Zengys118/FishFeeder-v2/sw/装配体2.STEP

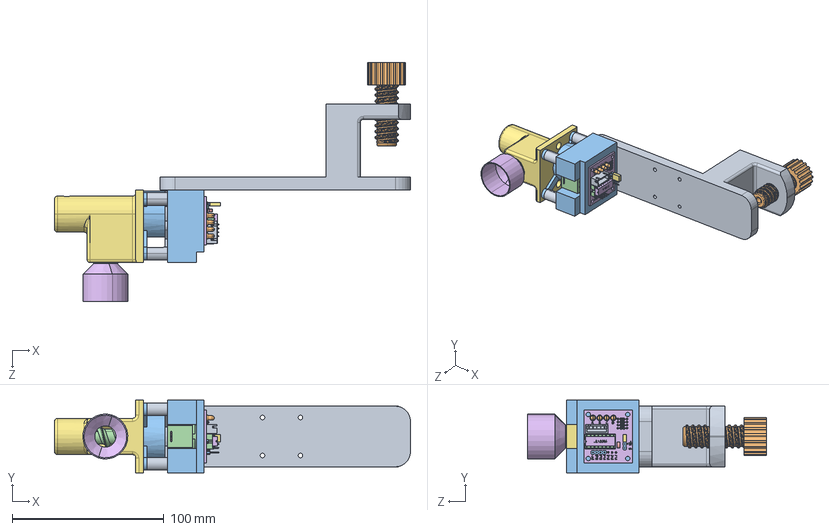
[picture p1: CAD file, 2026-11-01]
sw/装配体2.STEP
234.5 x 48.0 x 157.5 mm
夹具
夹具螺杆
电机料仓座
28BYJ-48_5VDC
board.step
5.2Kohm.step x 4
LED_Small.step x 4
DIP_16_Socket.step
ULN2003_DIP-16L.step
Pin_Header.step x 8
ceramic_capacitor_104.step
plug_uln2003.step
solder.step x 29
solder2.step x 10
solder1.step x 8
solder_dot_round.step x 3
cap.step
太阳轮
减速箱后盖
行星轮 x 3
减速箱壳体
螺杆
行星架
料仓
螺杆套筒
