Zengys118/FishFeeder-v2/Core/Inc/main.h

#define STEP_IN1_Pin GPIO_PIN_0
#define STEP_IN1_GPIO_Port GPIOB
#define STEP_IN2_Pin GPIO_PIN_1
#define STEP_IN2_GPIO_Port GPIOB
#define STEP_IN3_Pin GPIO_PIN_10
#define STEP_IN3_GPIO_Port GPIOB
#define STEP_IN4_Pin GPIO_PIN_11
#define STEP_IN4_GPIO_Port GPIOB
