Zengys118/FishFeeder-v2/(commit log)

2026-08-21 完善README并清理仓库文件
2026-08-21 补充MIT许可证内容
